LucasFernandes233/cockpit-iracing/volante/01_documentos/decisoes.md

# 📒 Log de decisões — Volante

Registro das decisões tomadas fora de uma revisão formal do documento de requisitos.
Cada decisão aqui deve ser incorporada à próxima revisão do
`Requisitos_e_Inventario`. Regra do projeto: **decisão anotada é decisão tomada.**

| # | Data | Decisão | Motivo / detalhe | Impacto |
|---|---|---|---|---|
| L1 | 2026-10-12 | **Base: decisão adiada.** Não definir a base agora; o usuário pode trocá-la no futuro. | A compra só ocorre na Fase 7; o volante tem USB próprio + adaptador QR e serve em qualquer base. | Resolve (adia) o ponto em aberto "Base" dos requisitos. Não bloqueia Fases 0–6. |
| L2 | 2026-10-12 | **Seletores rotativos da v2 = chave rotativa mecânica** (absoluta). | Posição absoluta (knob e jogo sempre em sincronia), barata, com detente autêntico; leitura por escada de resistores em 1 pino ADC. Encoder absoluto foi descartado (mais caro/complexo, ganho de durabilidade não essencial). | Fecha o ponto em aberto "Seletores rotativos da v2". Afeta só a v2. A definir na v2: nº de posições por seletor e pino ADC de cada um. |
| L3 | 2026-10-13 | **Mesmo botão com funções diferentes por carro (F1/GT3): adiar e testar na Fase 3.** SimHub (perfis por carro) é o plano B se o mapeamento global do iRacing incomodar. | iRacing amarra cada botão a uma função global; conflitos reais são poucos (B1, B8). SimHub entra na v2 de qualquer forma. Firmware descartado por complexidade. | Fecha o último ponto em aberto. Verificar na Fase 3 ao mapear no iRacing. |
