LucasFernandes233/cockpit-iracing/volante/02_maquete/placa_frontal_layout_MVP_rev00_A3.pdf

# PLACA FRONTAL — LAYOUT DE COMANDOS DO MVP

## Vista frontal (lado do piloto) · escala 1:1 · cotas em mm · origem no eixo da base

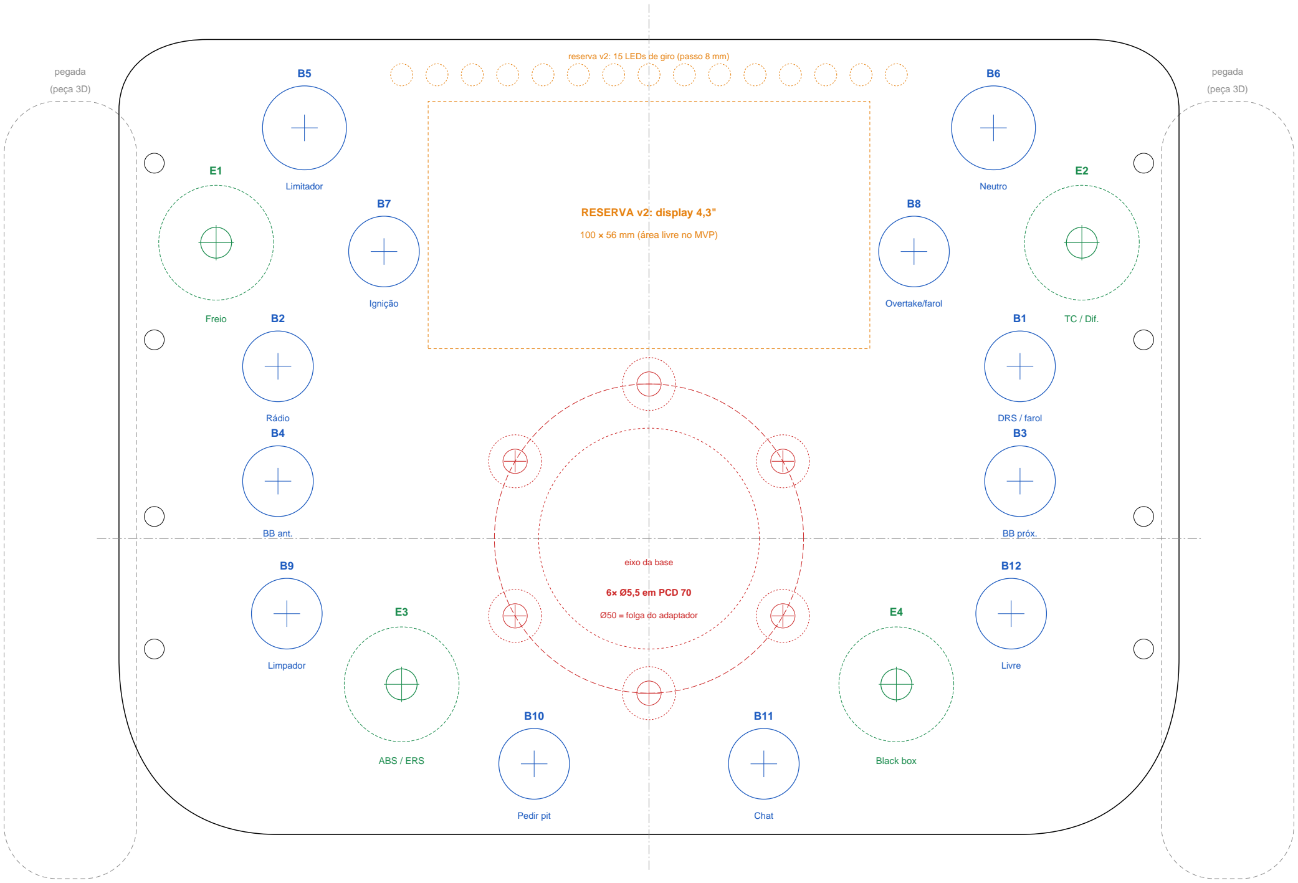
[picture p6: figure]
pegada; (peça 3D); RESERVA v2: display 4,3"; 100 × 56 mm (área livre no MVP); eixo da base; 6× Ø5,5 em PCD 70; Ø50 = folga do adaptador; Freio; TC / Dif.; ABS / ERS; Black box; DRS / farol; Rádio; BB próx.; BB ant.; Limitador; Neutro; Ignição; Overtake/farol; Limpador; Pedir pit; Chat; Livre

### CONFIRA A ESCALA: esta barra deve medir 100 mm

Imprimir em "tamanho real / 100%", nunca "ajustar à página".

### LEGENDA

Botão — furo Ø16 (B5, B6: Ø19, mais firme) Encoder EC11 — furo Ø7; tracejado = knob Ø26 Fixação na base — 6× Ø5,5 em PCD 70 Reserva para a v2 (display e LEDs)
Pegadas (peça separada, impressa em 3D)

### NOTAS

1. Placa: 236 × 180 mm; com pegadas: ~292 mm.
2. Furos Ø16/Ø19 assumem botões de painel; ajustar após escolher o componente.
3. Parafusos do cubo exigem chave livre:
nada dentro dos círculos de Ø12.
4. Aletas e embreagem: montadas atrás (desenho próprio, próxima revisão).
5. Posições a validar na maquete 1:1.

### VOL-MEC — Placa frontal

Projeto Cockpit iRacing · Jarvis

Revisão: rev00

Data: 12/10/2026

reserva v2: 15 LEDs de giro (passo 8 mm)
