LucasFernandes233/cockpit-iracing/volante/04_cad/previa_volante_P1.png

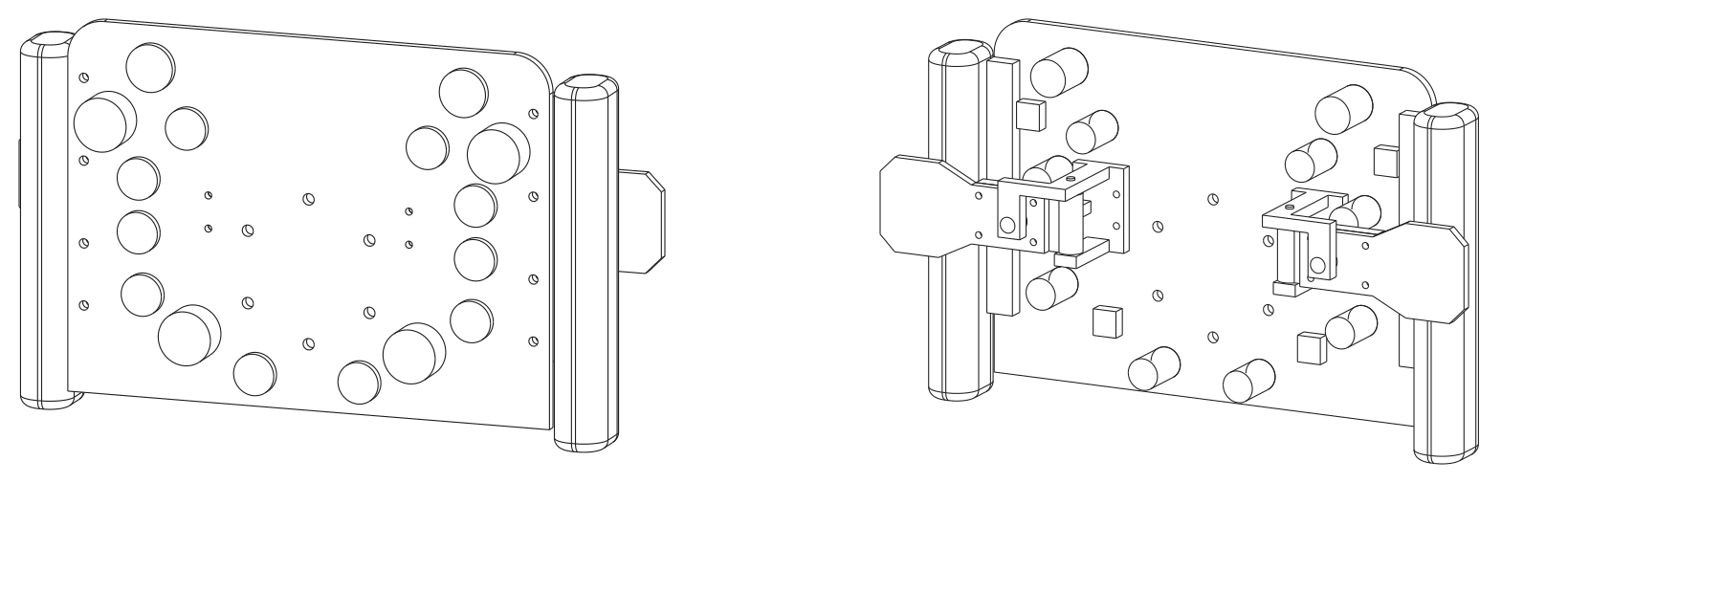
volante/04_cad/previa_volante_P1.png
