LucasFernandes233/cockpit-iracing/volante/01_documentos/orçamento.xlsx

ORÇAMENTO — Volante de Simulação · Fase 1 (rev01)
Fornecedores e preços pesquisados em out/2026 (Mercado Livre / Amazon / Shopee) — CONFIRMAR antes de comprar, preço e estoque mudam. Preencha Gasto / Link escolhido / Status.
⚠️ Cabo USB tem que ter DADOS (cabo só de carga não funciona).
⚠️ Ímã N52 em formato DISCO/CILINDRO (não 'bloco'); nunca N35.
⚠️ Set screw M8 em AÇO (não inox A2/A4): o ímã de retorno precisa atrair aço.
Item | Qtd | Previsto mín (R$) | Previsto máx (R$) | Gasto (R$) | Fornecedor | Link (ref.) | Status
A. ELETRÔNICA (protótipo em protoboard)
Raspberry Pi Pico H (RP2040) — pinos JÁ soldados (versão 'H') | 2 (1 reserva) | 80 | 110 |  | Mercado Livre | https://produto.mercadolivre.com.br/MLB-3181190378-raspberry-pi-pico-h-rp2040-dual-core-arm-cortex-m0-264kb-_JM | Pendente
Kit 25 push button 12×12 mm (chave táctil) | 1 kit (usa 15) | 15 | 25 |  | Mercado Livre | https://produto.mercadolivre.com.br/MLB-1757293010-kit-25-push-button-12x12-chave-tactil-capa-_JM | Pendente
Diodo 1N4148 — kit 100 peças | 1 kit (usa 15) | 8 | 15 |  | Mercado Livre | https://produto.mercadolivre.com.br/MLB-2030445588-diodo-de-sinal-1n4148-kit-100-pecas-_JM | Pendente
Encoder rotativo EC11 (20 pulsos, c/ clique) — pacote 10 | 1 pct (usa 5) | 45 | 90 |  | Mercado Livre | https://produto.mercadolivre.com.br/MLB-2936813951-encoder-rotativo-ec11-potenciometro-10-unidades-arduino-_JM | Pendente
Sensor Hall linear SS49E — kit 5 peças | 1 kit (usa 3) | 12 | 25 |  | Mercado Livre | https://produto.mercadolivre.com.br/MLB-1367538567-sensor-hall-49e-oh49e-ss49e-analogico-kit-5-pecas-_JM | Pendente
Kit protoboard 830 pontos + 65 jumpers (MB102) | 1 kit | 34 | 50 |  | Mercado Livre | https://www.mercadolivre.com.br/kit-protoboard-830-pontos-fonte-mb102-kit-jumpers-arduino/p/MLB37389913 | Pendente
Protoboard 830 pontos — 2ª unidade | 1 | 15 | 25 |  | Mercado Livre | https://lista.mercadolivre.com.br/protoboard-830 | Pendente
Cabo USB-A → micro-USB com DADOS (ex.: C3Tech CB-M11) | 1 | 10 | 20 |  | Mercado Livre | https://www.mercadolivre.com.br/cabo-micro-usb-1m-preto-2a-c3tech-conector-v8-cb-m11-transferencia-de-dados/p/MLB22252705 | Pendente
B. ÍMÃS DE NEODÍMIO N52 (formato DISCO)
Ímã N52 Ø10 × 5 mm DISCO (retorno da aleta) — pacote | 1 pct (usa 2) | 40 | 55 |  | Mercado Livre | https://lista.mercadolivre.com.br/ima-de-neod%C3%ADmio-10x5mm | Pendente
Ímã N52 Ø5 × 3 mm DISCO (sensor Hall) — pacote | 1 pct (usa 6) | 20 | 40 |  | Mercado Livre | https://lista.mercadolivre.com.br/ima-neodimio-5x3 | Pendente
C. FERRAGEM / MECÂNICA
Eixo: barra redonda inox 304 Ø4 mm (cortar 2× ~44 mm) | 1 barra | 19 | 31 |  | Mercado Livre | https://www.mercadolivre.com.br/barra-redonda-de-inox-304--4mm-x-36-cm/up/MLBU1980168840 | Pendente
Bucha de bronze Ø4 × Ø6 × 4 mm ⚠️ ver obs. (OD6 raro) | 4 | 30 | 50 |  | A confirmar | https://lista.mercadolivre.com.br/bucha-bronze-sinterizado | Pendente
Set screw M8 × 10 ponta plana — AÇO (não inox!) DIN 913 | 2 (pct) | 15 | 30 |  | Mercado Livre | https://produto.mercadolivre.com.br/MLB-3273317985-parafuso-allen-sem-cabeca-com-rebaixo-m8-x-10mm-20-pecas-_JM | Pendente
Kit insertos latão a quente M2–M5 (cobre M3 e M4) | 1 kit | 30 | 60 |  | Amazon | https://www.amazon.com.br/inser%C3%A7%C3%B5es-impress%C3%A3o-serrilhadas-rosqueado-componentes/dp/B0CY2HGFB8 | Pendente
Kit parafusos allen M3/M4/M5 + porcas (cobre M3×8, M4, M5) | 1 kit | 50 | 75 |  | Amazon | https://www.amazon.com.br/Parafusos-Allen-Cabe%C3%A7a-Redonda-Porcas/dp/B0FPZ2M1YF | Pendente
TOTAL FASE 1
❌ NÃO COMPRAR AGORA (dependem da maquete / Fase 7)
12 botões de painel (10× Ø16 + 2× Ø19) — corpo ≤ 25 mm atrás da placa |  |  |  |  |  |  | após a maquete (Fase 2)
4 knobs Ø26 |  |  |  |  |  |  | após a maquete (Fase 2)
Base Moza R3 + adaptador quick release |  |  |  |  |  |  | Fase 7
OBSERVAÇÕES
• Bucha de bronze: a medida Ø4×Ø6×4 (OD 6 mm) quase não existe no varejo; o comum é Ø4×Ø8×8 (OD 8 mm). Como o CAD é paramétrico, o ideal é ajustar o furo do carregador/suporte para a bucha Ø8 disponível — decidir com quem mantém o CAD.
• Eixo Ø4: a barra de inox serve (o eixo NÃO precisa ser magnético, só o set screw M8). Cortar 2 pedaços de ~44 mm.
• Total subiu vs. estimativa inicial porque ímãs/parafusos/insertos são vendidos em PACOTES/KITS (sobra reserva).
• Shopee costuma ter os itens de eletrônica mais baratos — vale comparar antes de fechar.
• Portão da Fase 1: receber e conferir item por item; medir ímãs e eixo com paquímetro.
