LucasFernandes233/cockpit-iracing/volante/04_cad/impressao_stl/suporte_aleta_esq.stl

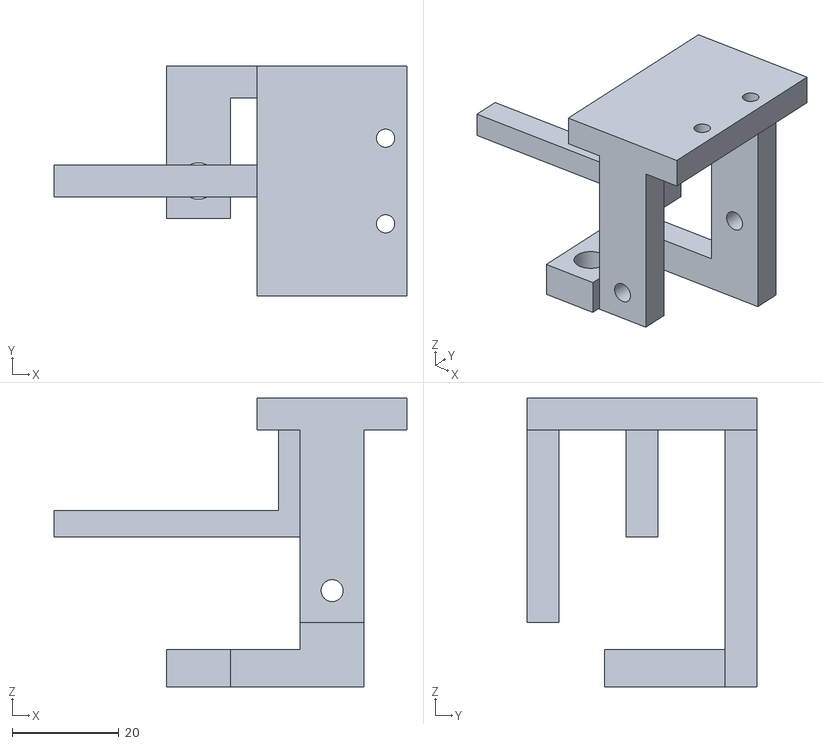
[picture p8: CAD file, 2026-10-13]
volante/04_cad/impressao_stl/suporte_aleta_esq.stl
66.0 x 43.0 x 54.0
