LucasFernandes233/cockpit-iracing/volante/04_cad/pecas_step/pegada_dir.step

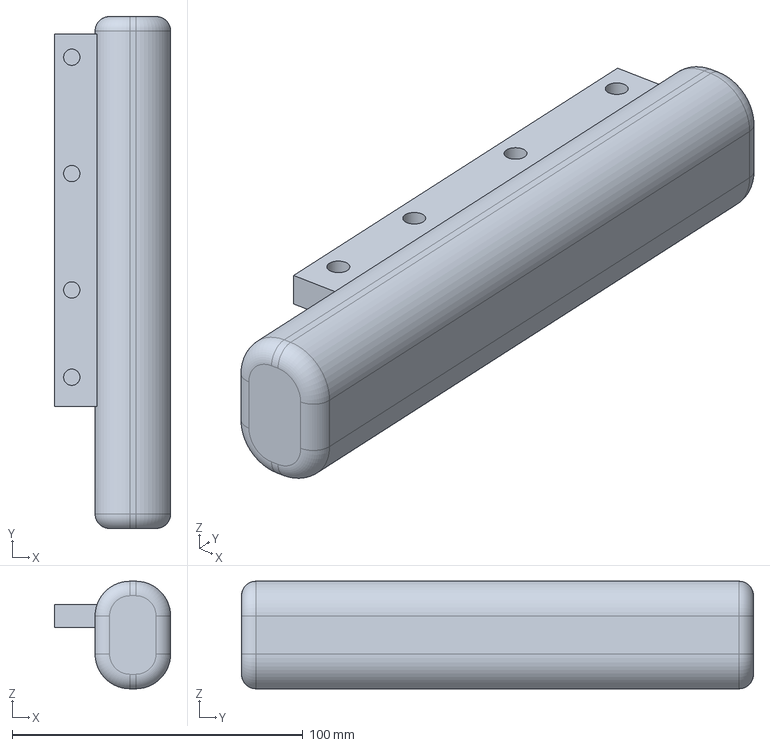
[picture p9: CAD file, 2026-10-13]
volante/04_cad/pecas_step/pegada_dir.step
40.0 x 176.0 x 37.0 mm
