LucasFernandes233/cockpit-iracing/volante/04_cad/volante_P1_montagem.step

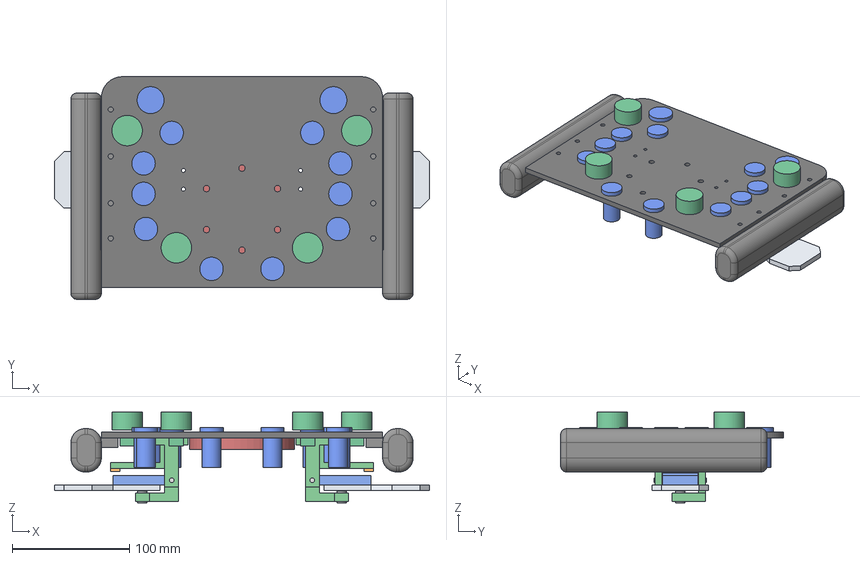
[picture p10: CAD file, 2026-10-13]
volante/04_cad/volante_P1_montagem.step
320.0 x 190.0 x 77.3 mm
placa_frontal
pegada_dir
pegada_esq
suporte_aleta_dir
suporte_aleta_esq
batente_dir
batente_esq
sensor_dir
sensor_esq
parafuso_m8_dir
parafuso_m8_esq
eixo_dir
eixo_esq
chapa_aleta_dir
chapa_aleta_esq
carregador_dir
carregador_esq
ima_retorno_dir
ima_retorno_esq
ima_sensor_dir
ima_sensor_esq
REF_botoes
REF_encoders
REF_adaptador_QR
