LucasFernandes233/cockpit-iracing/volante/04_cad/impressao_stl/carregador_aleta_x2.stl

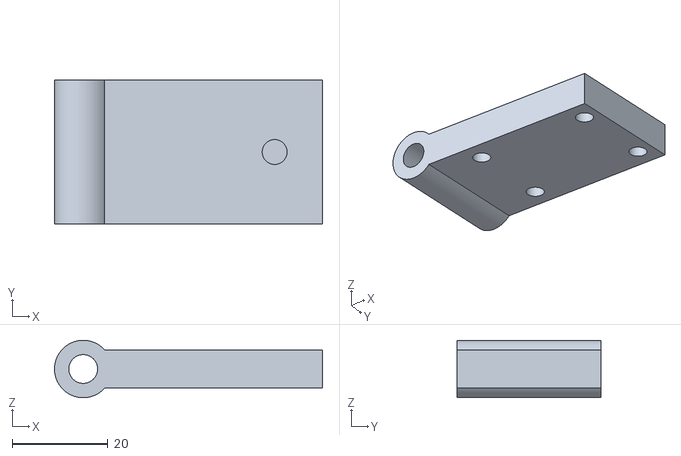
[picture p11: CAD file, 2026-10-13]
volante/04_cad/impressao_stl/carregador_aleta_x2.stl
56.0 x 30.0 x 12.0
