LucasFernandes233/cockpit-iracing/volante/04_cad/pecas_step/batente_TPU_x2.step

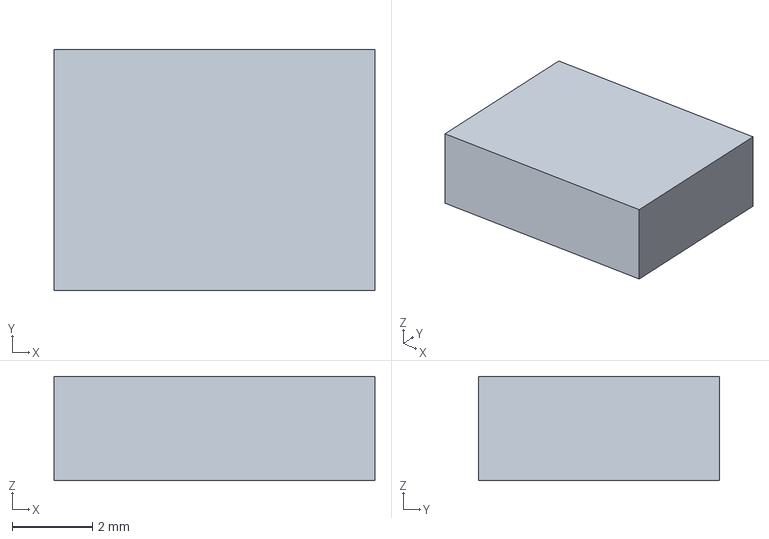
[picture p12: CAD file, 2026-10-13]
volante/04_cad/pecas_step/batente_TPU_x2.step
8.00 x 6.00 x 2.60 mm
