LucasFernandes233/cockpit-iracing/volante/04_cad/impressao_stl/chapa_aleta_x2.stl

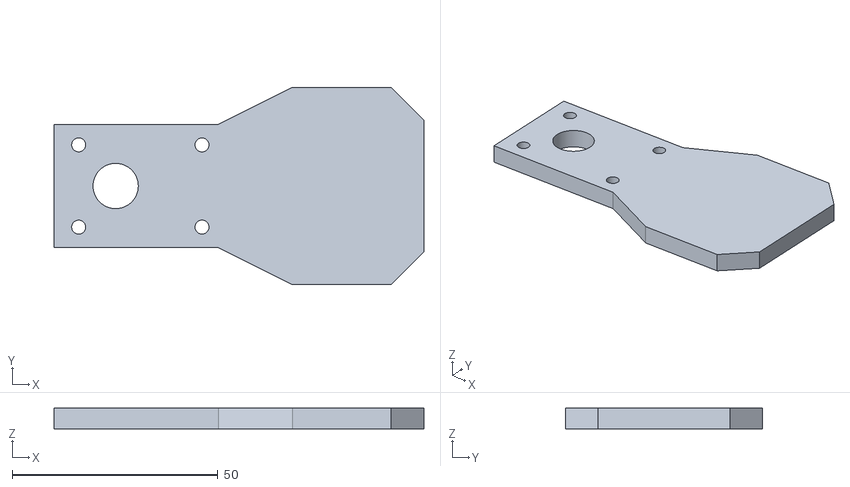
[picture p13: CAD file, 2026-10-13]
volante/04_cad/impressao_stl/chapa_aleta_x2.stl
90.0 x 48.0 x 5.00
