LucasFernandes233/cockpit-iracing/volante/04_cad/pecas_step/placa_frontal_P1.step

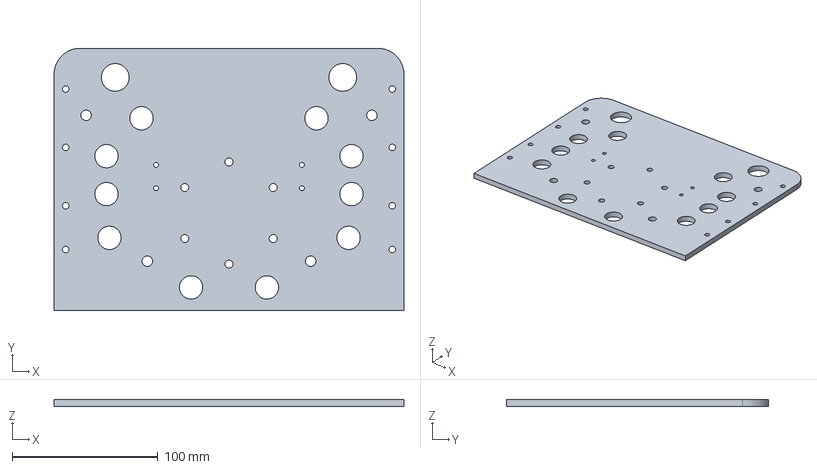
[picture p14: CAD file, 2026-10-13]
volante/04_cad/pecas_step/placa_frontal_P1.step
240.0 x 180.0 x 5.00 mm
