LucasFernandes233/cockpit-iracing/(list of files, cad)

Other CAD files:
volante/04_cad/pecas_step/carregador_aleta_x2.step
volante/04_cad/impressao_stl/suporte_aleta_dir.stl
volante/04_cad/impressao_stl/placa_frontal_P1.stl
volante/04_cad/pecas_step/chapa_aleta_x2.step
volante/04_cad/impressao_stl/pegada_dir.stl
volante/04_cad/pecas_step/suporte_aleta_dir.step
volante/04_cad/impressao_stl/batente_TPU_x2.stl
volante/04_cad/pecas_step/pegada_esq.step
volante/04_cad/impressao_stl/pegada_esq.stl
volante/04_cad/pecas_step/suporte_aleta_esq.step
