LucasFernandes233/cockpit-iracing/volante/04_cad/relatorio_verificacao.txt

VERIFICAÇÃO DO MODELO 3D — protótipo P1 rev01

Aleta repouso (0.00°): nenhuma interferência
   folga carregador_dir ↔ REF_botoes: 7.00 mm
   folga chapa_aleta_dir ↔ pegada_dir: 11.00 mm
   folga carregador_dir ↔ batente_dir: 3.40 mm
   folga ima_sensor_dir ↔ sensor_dir: 6.00 mm
Aleta acionada (encosta no batente) (3.85°): nenhuma interferência
   folga carregador_dir ↔ REF_botoes: 4.83 mm
   folga chapa_aleta_dir ↔ pegada_dir: 5.99 mm
   folga carregador_dir ↔ batente_dir: 0.05 mm
   folga ima_sensor_dir ↔ sensor_dir: 3.16 mm

MASSAS ESTIMADAS
   placa_frontal_P1: 200.1 cm³ → 152 g
   pegada_dir: 160.4 cm³ → 102 g
   pegada_esq: 160.4 cm³ → 102 g
   suporte_aleta_dir: 17.7 cm³ → 14 g
   suporte_aleta_esq: 17.7 cm³ → 14 g
   carregador_aleta_x2: 12.8 cm³ → 21 g
   chapa_aleta_x2: 16.2 cm³ → 37 g
   batente_TPU_x2: 0.1 cm³ → 0 g
   TOTAL impresso + chapas: ~443 g (sem eletrônica, botões, ímãs e parafusos)
