LucasFernandes233/cockpit-iracing/volante/02_maquete/placa_frontal_layout_MVP_rev00_2xA4.pdf

# PLACA FRONTAL — LAYOUT DE COMANDOS DO MVP

## Vista frontal (lado do piloto) · escala 1:1 · cotas em mm · origem no eixo da base

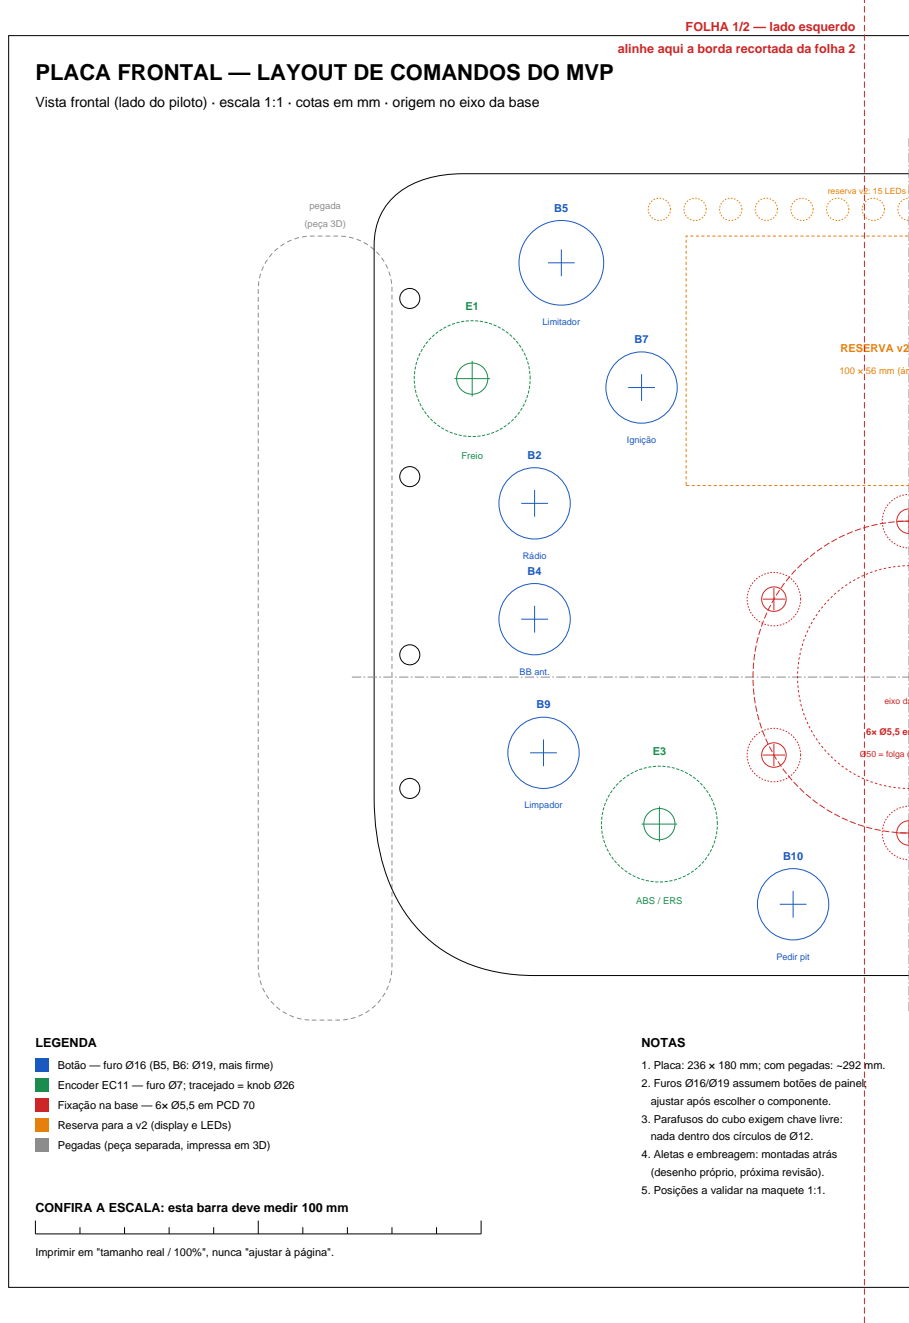
[picture p29: page 1]
LEGENDA; NOTAS; pegada; (peça 3D); RESERVA v2: display 4,3"; 6× Ø5,5 em PCD 70; Freio; ABS / ERS; Rádio B4; BB ant.; Limitador; Ignição; Limpador; Pedir pit

FOLHA 1/2 — lado esquerdo

alinhe aqui a borda recortada da folha 2

reserva v2: 15 LEDs de giro (passo 8 mm)

100 × 56 mm (área livre no MVP)

eixo da base

Ø50 = folga do adaptador

Botão — furo Ø16 (B5, B6: Ø19, mais firme)
Encoder EC11 — furo Ø7; tracejado = knob Ø26
Fixação na base — 6× Ø5,5 em PCD 70
Reserva para a v2 (display e LEDs)
Pegadas (peça separada, impressa em 3D)

1. Placa: 236 × 180 mm; com pegadas: ~292 mm.
2. Furos Ø16/Ø19 assumem botões de painel;
ajustar após escolher o componente.
3. Parafusos do cubo exigem chave livre:
nada dentro dos círculos de Ø12.
4. Aletas e embreagem: montadas atrás
(desenho próprio, próxima revisão).
5. Posições a validar na maquete 1:1.

CONFIRA A ESCALA: esta barra deve medir 100 mm

Imprimir em "tamanho real / 100%", nunca "ajustar à página".

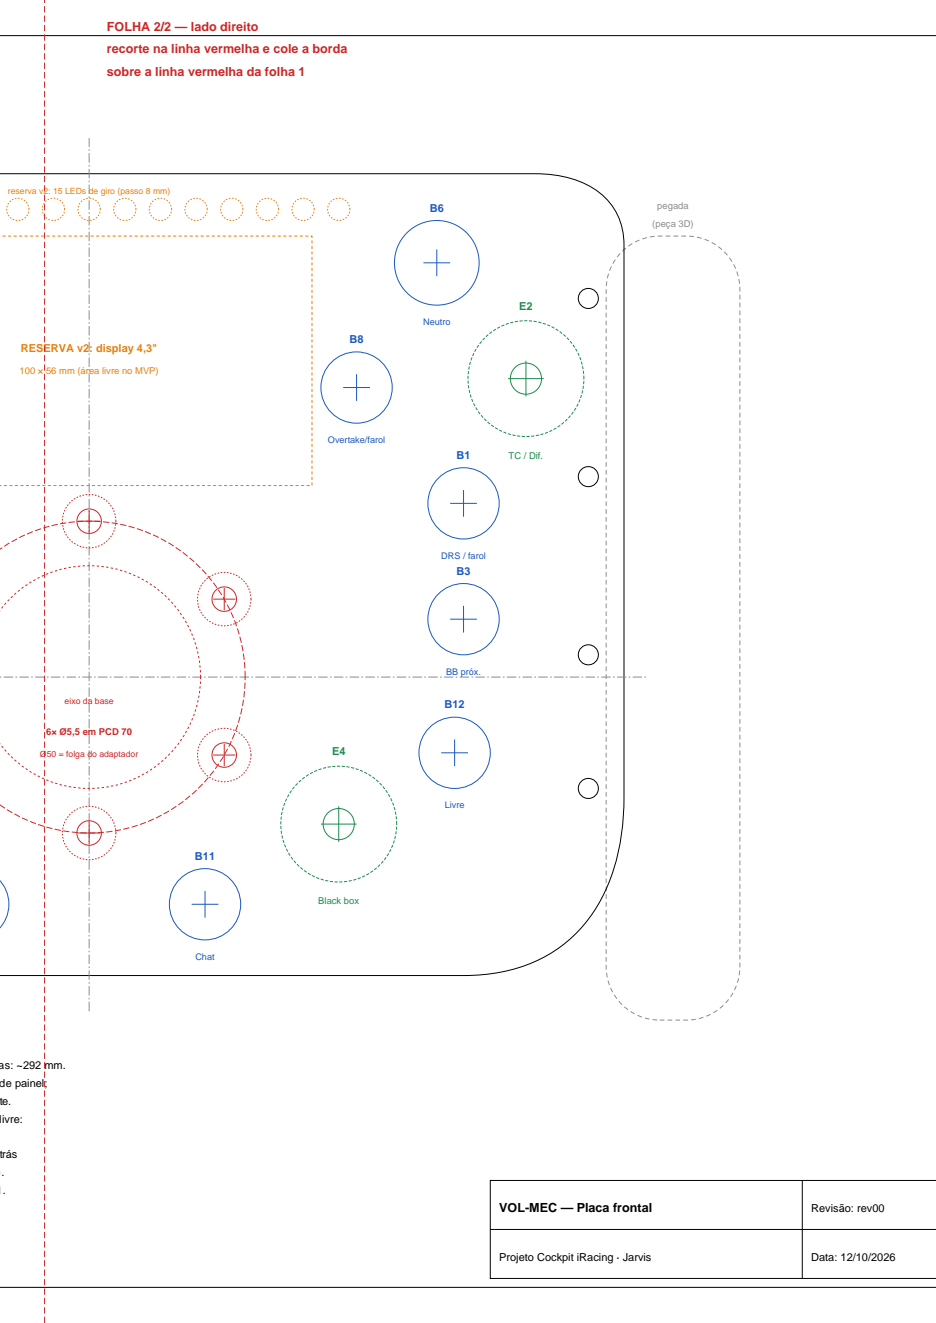
[picture p30: page 2]
Revisão: rev00; Data: 12/10/2026; pegada; (peça 3D); RESERVA v2: display 4,3"; 6× Ø5,5 em PCD 70; TC / Dif.; Black box; DRS / farol B3; BB próx.; Neutro; Overtake/farol; Chat; Livre

FOLHA 2/2 — lado direito
recorte na linha vermelha e cole a borda
sobre a linha vermelha da folha 1

reserva v2: 15 LEDs de giro (passo 8 mm)

100 × 56 mm (área livre no MVP)

eixo da base

Ø50 = folga do adaptador

1. Placa: 236 × 180 mm; com pegadas: ~292 mm.
2. Furos Ø16/Ø19 assumem botões de painel;
ajustar após escolher o componente.
3. Parafusos do cubo exigem chave livre:

4. Aletas e embreagem: montadas atrás
(desenho próprio, próxima revisão).
5. Posições a validar na maquete 1:1.

VOL-MEC — Placa frontal

Projeto Cockpit iRacing · Jarvis
