LucasFernandes233/cockpit-iracing/(commit log)

2026-10-13 Estrutura inicial do projeto cockpit
    - Adiciona estrutura de pastas (hardware/volante, firmware, software, docs)
    - Configura .gitignore (FreeCAD, firmware, Python/Node, SO)
    - Atualiza README com descricao do projeto e roadmap
2026-10-13 Fase 0: organizacao do projeto do volante
    - Reestrutura o repo conforme o roteiro (volante/{requisitos,mecanica,
    eletronica,firmware,fabricacao,testes})
    - Adiciona o roteiro mestre do projeto (Roteiro_Projeto_Volante.pdf)
    - README como indice de arquivos (acha qualquer arquivo em <1 min)
    - Orcamento escrito (orcamento.md) e planilha de custos (planilha_custos.csv)
    - READMEs por pasta documentando o que vai em cada uma
    [planilha_custos.csv]
2026-10-13 Fase 0: adiciona arquivos do projeto (CAD, firmware, desenhos)
    - Firmware do Pico (volante_mvp.ino) em volante/firmware/
    - Pacote CAD extraido: modelo CadQuery, STEP, relatorios e previa em
    volante/mecanica/; STL e DXF em volante/fabricacao/
    - Desenhos da placa (A3/2xA4) e das aletas em volante/mecanica/
    - Atualiza indice do README e READMEs de pasta
    - Pendentes: doc de Requisitos e Inventario + manual de montagem
    [aleta_chapa_direita_rev00.dxf, batente_TPU_x2.step, batente_TPU_x2.stl, carregador_aleta_x2.step, carregador_aleta_x2.stl, chapa_aleta_x2.step, chapa_aleta_x2_rev00.dxf, pegada_dir.step]
2026-10-13 Adota pacote projeto_main (rev01) como estrutura do volante
    - Substitui a estrutura anterior pelo pacote principal rev01 (100% impressao 3D)
    - Organiza por frente: volante/{01_documentos..06_fontes}
    - Adiciona os 2 arquivos que faltavam: Requisitos_e_Inventario.pdf e
    manual_montagem_volante_P1_rev01.pdf; inclui scripts fonte (06_fontes)
    - Remove arquivos rev00 obsoletos (DXF de aluminio, orcamento/planilha antigos)
    - README reescrito como indice da nova estrutura + orcamento rev01
    [aleta_chapa_direita_rev00.dxf, batente_TPU_x2.step, batente_TPU_x2.stl, carregador_aleta_x2.step, carregador_aleta_x2.stl, chapa_aleta_x2.step, chapa_aleta_x2.stl, chapa_aleta_x2_rev00.dxf]
2026-10-13 Registra decisoes: base adiada e seletores v2 = chave mecanica
    Cria volante/01_documentos/decisoes.md (log de decisoes que alimenta a
    proxima revisao dos requisitos).
2026-10-13 Fase 1: lista de compras (rev01) com planilha de custos
    - Eletronica (protoboard), imas N52 e ferragem, com quantidades e reservas
    - Medidas confirmadas no modelo CAD: eixo Ø4x~44, ima retorno Ø10x5 (rev01),
    set screw M8, insertos M3/M4
    - Marca o que NAO comprar agora (botoes de painel, knobs, base) e o portao
    - Colunas de rastreio: previsto/gasto/fornecedor/status
2026-10-13 Fase 1: lista de compras como planilha (orçamento.xlsx)
    - Gera orçamento.xlsx (Excel) com total somado automaticamente, coluna de
    gasto para preencher e dropdown de status
    - Fornecedores priorizando Mercado Livre, Shopee e Amazon
    - Consolida a lista no .xlsx e remove o .md antigo (fonte unica)
    [orçamento.xlsx]
2026-10-13 Fase 1: orçamento com fornecedores reais (ML/Amazon) e links
    - Pesquisa de fornecedores e precos (out/2026) com links clicaveis
    - Flags: set screw M8 em ACO (nao inox); ima em disco; bucha Ø6 rara
    - Ferragem consolidada em kits reais (insertos M2-M5, parafusos M3-M5)
    - Secao de observacoes com a pendencia da bucha e portao da fase
    [orçamento.xlsx]
